ETML-ES-SLO/PRJ_2227_BoiteABruitage/soft/Version_B_MSI/README.md

"# PROJET-POBJ" 
to generate new wav file : https://tomeko.net/online_tools/wave_gen.php?lang=en
