ETML-ES-SLO/PRJ_2227_BoiteABruitage/hard/2227_BoiteBruitages_1A_LDD/Project Outputs for 2227_BoiteBruitage/Reports/Electrical Rules Check.html

Altium

# Electrical Rule Check Report

Date: | | 22.03.2023
Time: | | 09:31:39
Filename: | | C:\Users\pd55xhr\OneDrive - Education Vaud\Semestre 3\Projet\rendu design\Hardware\PCB_Project\Project Outputs for 2227_BoiteBruitage\Reports\Electrical Rules Check.html

Class | Document | Message
Warning | Schéma_Global.SchDoc | Net NetC6_2 has no driving source (Pin C6-2, Pin R26-1, Pin R28-2, Pin U5-6)
Warning | Schéma_Global.SchDoc | Net NetC9_2 has no driving source (Pin C9-2, Pin R27-1, Pin R29-2, Pin U5-3)
Warning | Schéma_Global.SchDoc | Net Pot has no driving source (Pin R25-2, Pin TP11-1, Pin U4-19)
Warning | Schéma_Global.SchDoc | Net SPI2 CLK has no driving source (Pin TP14-1, Pin U4-15, Pin U6-6)

Back to top
