ETML-ES-SLO/PRJ_2227_BoiteABruitage/hard/2227_BoiteBruitages_1A_LDD/Project Outputs for 2227_BoiteBruitage/Reports/Footprint Comparison Report.html

Altium customize

# Footprint Comparison Report

Date: | | 22.03.2023
Time: | | 09:31:40
Elapsed Time: | | 00:00:00
Filename: | | C:\Users\pd55xhr\OneDrive - Education Vaud\Semestre 3\Projet\rendu design\Hardware\PCB_Project\22270A_BoiteBruitage_LDD.PcbDoc

## Contents

Contents

Components Status Summary

Matched Components List

## Components Status Summary

## Matched Components List

Designator | Footprint | Footprint reference | Footprint to reference Library
C1 | C0805 | C0805 | C:\Users\pd55xhr\OneDrive - Education Vaud\Semestre 3\Projet\rendu design\Hardware\PCB_Project\ES_Class6C_2L.PcbLib
C2 | C0805 | C0805 | C:\Users\pd55xhr\OneDrive - Education Vaud\Semestre 3\Projet\rendu design\Hardware\PCB_Project\ES_Class6C_2L.PcbLib
C3 | C0805 | C0805 | C:\Users\pd55xhr\OneDrive - Education Vaud\Semestre 3\Projet\rendu design\Hardware\PCB_Project\ES_Class6C_2L.PcbLib
C4 | C0805 | C0805 | C:\Users\pd55xhr\OneDrive - Education Vaud\Semestre 3\Projet\rendu design\Hardware\PCB_Project\ES_Class6C_2L.PcbLib
C5 | C0805 | C0805 | C:\Users\pd55xhr\OneDrive - Education Vaud\Semestre 3\Projet\rendu design\Hardware\PCB_Project\ES_Class6C_2L.PcbLib
C6 | C0805 | C0805 | C:\Users\pd55xhr\OneDrive - Education Vaud\Semestre 3\Projet\rendu design\Hardware\PCB_Project\ES_Class6C_2L.PcbLib
C7 | C0805 | C0805 | C:\Users\pd55xhr\OneDrive - Education Vaud\Semestre 3\Projet\rendu design\Hardware\PCB_Project\ES_Class6C_2L.PcbLib
C8 | C0805 | C0805 | C:\Users\pd55xhr\OneDrive - Education Vaud\Semestre 3\Projet\rendu design\Hardware\PCB_Project\ES_Class6C_2L.PcbLib
C9 | C0805 | C0805 | C:\Users\pd55xhr\OneDrive - Education Vaud\Semestre 3\Projet\rendu design\Hardware\PCB_Project\ES_Class6C_2L.PcbLib
C10 | C0805 | C0805 | C:\Users\pd55xhr\OneDrive - Education Vaud\Semestre 3\Projet\rendu design\Hardware\PCB_Project\ES_Class6C_2L.PcbLib
C11 | C0805 | C0805 | C:\Users\pd55xhr\OneDrive - Education Vaud\Semestre 3\Projet\rendu design\Hardware\PCB_Project\ES_Class6C_2L.PcbLib
C12 | C0805 | C0805 | C:\Users\pd55xhr\OneDrive - Education Vaud\Semestre 3\Projet\rendu design\Hardware\PCB_Project\ES_Class6C_2L.PcbLib
C13 | C0805 | C0805 | C:\Users\pd55xhr\OneDrive - Education Vaud\Semestre 3\Projet\rendu design\Hardware\PCB_Project\ES_Class6C_2L.PcbLib
C14 | C0805 | C0805 | C:\Users\pd55xhr\OneDrive - Education Vaud\Semestre 3\Projet\rendu design\Hardware\PCB_Project\ES_Class6C_2L.PcbLib
C15 | C0805 | C0805 | C:\Users\pd55xhr\OneDrive - Education Vaud\Semestre 3\Projet\rendu design\Hardware\PCB_Project\ES_Class6C_2L.PcbLib
C16 | C0805 | C0805 | C:\Users\pd55xhr\OneDrive - Education Vaud\Semestre 3\Projet\rendu design\Hardware\PCB_Project\ES_Class6C_2L.PcbLib
C17 | CAP_EEEFK1E331GP | CAP_EEEFK1E331GP | C:\Users\pd55xhr\OneDrive - Education Vaud\Semestre 3\Projet\rendu design\Hardware\PCB_Project\2227_BoiteBruitage.PcbLib
C18 | CAP_EEEFK1E331GP | CAP_EEEFK1E331GP | C:\Users\pd55xhr\OneDrive - Education Vaud\Semestre 3\Projet\rendu design\Hardware\PCB_Project\2227_BoiteBruitage.PcbLib
F1 | PIN-W2/E2.8 | PIN-W2/E2.8 | C:\Users\Public\Documents\Altium\AD21\Library\Miscellaneous Devices.IntLib
J1 | GCT_MEM2067-02-180-00-A_REVB | GCT_MEM2067-02-180-00-A_REVB | C:\Users\pd55xhr\OneDrive - Education Vaud\Semestre 3\Projet\rendu design\Hardware\PCB_Project\2227_BoiteBruitage.PcbLib
J2 | CUI_SJ1-3533NG | CUI_SJ1-3533NG | C:\Users\pd55xhr\OneDrive - Education Vaud\Semestre 3\Projet\rendu design\Hardware\PCB_Project\2227_BoiteBruitage.PcbLib
L1 | CDRH125101MC | CDRH125101MC | C:\Users\pd55xhr\OneDrive - Education Vaud\Semestre 3\Projet\rendu design\Hardware\PCB_Project\2227_BoiteBruitage.PcbLib
LS1 | PIN2 | PIN2 | C:\Users\Public\Documents\Altium\AD21\Library\Miscellaneous Devices.IntLib
P1 | 691312710002 | 691312710002 | C:\Users\pd55xhr\OneDrive - Education Vaud\Semestre 3\Projet\rendu design\Hardware\PCB_Project\2227_BoiteBruitage.PcbLib
P2 | 691312710002 | 691312710002 | C:\Users\pd55xhr\OneDrive - Education Vaud\Semestre 3\Projet\rendu design\Hardware\PCB_Project\2227_BoiteBruitage.PcbLib
P3 | 691312710002 | 691312710002 | C:\Users\pd55xhr\OneDrive - Education Vaud\Semestre 3\Projet\rendu design\Hardware\PCB_Project\2227_BoiteBruitage.PcbLib
P4 | 691312710002 | 691312710002 | C:\Users\pd55xhr\OneDrive - Education Vaud\Semestre 3\Projet\rendu design\Hardware\PCB_Project\2227_BoiteBruitage.PcbLib
P5 | 691312710002 | 691312710002 | C:\Users\pd55xhr\OneDrive - Education Vaud\Semestre 3\Projet\rendu design\Hardware\PCB_Project\2227_BoiteBruitage.PcbLib
P6 | 691312710002 | 691312710002 | C:\Users\pd55xhr\OneDrive - Education Vaud\Semestre 3\Projet\rendu design\Hardware\PCB_Project\2227_BoiteBruitage.PcbLib
P7 | 691312710002 | 691312710002 | C:\Users\pd55xhr\OneDrive - Education Vaud\Semestre 3\Projet\rendu design\Hardware\PCB_Project\2227_BoiteBruitage.PcbLib
P8 | 691312710002 | 691312710002 | C:\Users\pd55xhr\OneDrive - Education Vaud\Semestre 3\Projet\rendu design\Hardware\PCB_Project\2227_BoiteBruitage.PcbLib
P9 | HDR1X6 | HDR1X6 | C:\Users\Public\Documents\Altium\AD21\Library\Miscellaneous Connectors.IntLib
P10 | 691312710002 | 691312710002 | C:\Users\pd55xhr\OneDrive - Education Vaud\Semestre 3\Projet\rendu design\Hardware\PCB_Project\2227_BoiteBruitage.PcbLib
P11 | 691312710002 | 691312710002 | C:\Users\pd55xhr\OneDrive - Education Vaud\Semestre 3\Projet\rendu design\Hardware\PCB_Project\2227_BoiteBruitage.PcbLib
P12 | MHDR1X2 | MHDR1X2 | C:\Users\Public\Documents\Altium\AD21\Library\Miscellaneous Connectors.IntLib
P13 | 691312710002 | 691312710002 | C:\Users\pd55xhr\OneDrive - Education Vaud\Semestre 3\Projet\rendu design\Hardware\PCB_Project\2227_BoiteBruitage.PcbLib
R1 | C1206 | C1206 | C:\Users\pd55xhr\OneDrive - Education Vaud\Semestre 3\Projet\rendu design\Hardware\PCB_Project\ES_Class6C_2L.PcbLib
R2 | C1206 | C1206 | C:\Users\pd55xhr\OneDrive - Education Vaud\Semestre 3\Projet\rendu design\Hardware\PCB_Project\ES_Class6C_2L.PcbLib
R3 | C1206 | C1206 | C:\Users\pd55xhr\OneDrive - Education Vaud\Semestre 3\Projet\rendu design\Hardware\PCB_Project\ES_Class6C_2L.PcbLib
R4 | C1206 | C1206 | C:\Users\pd55xhr\OneDrive - Education Vaud\Semestre 3\Projet\rendu design\Hardware\PCB_Project\ES_Class6C_2L.PcbLib
R7 | C1206 | C1206 | C:\Users\pd55xhr\OneDrive - Education Vaud\Semestre 3\Projet\rendu design\Hardware\PCB_Project\ES_Class6C_2L.PcbLib
R8 | C1206 | C1206 | C:\Users\pd55xhr\OneDrive - Education Vaud\Semestre 3\Projet\rendu design\Hardware\PCB_Project\ES_Class6C_2L.PcbLib
R9 | C1206 | C1206 | C:\Users\pd55xhr\OneDrive - Education Vaud\Semestre 3\Projet\rendu design\Hardware\PCB_Project\ES_Class6C_2L.PcbLib
R10 | C1206 | C1206 | C:\Users\pd55xhr\OneDrive - Education Vaud\Semestre 3\Projet\rendu design\Hardware\PCB_Project\ES_Class6C_2L.PcbLib
R11 | C1206 | C1206 | C:\Users\pd55xhr\OneDrive - Education Vaud\Semestre 3\Projet\rendu design\Hardware\PCB_Project\ES_Class6C_2L.PcbLib
R12 | C1206 | C1206 | C:\Users\pd55xhr\OneDrive - Education Vaud\Semestre 3\Projet\rendu design\Hardware\PCB_Project\ES_Class6C_2L.PcbLib
R13 | C1206 | C1206 | C:\Users\pd55xhr\OneDrive - Education Vaud\Semestre 3\Projet\rendu design\Hardware\PCB_Project\ES_Class6C_2L.PcbLib
R14 | C1206 | C1206 | C:\Users\pd55xhr\OneDrive - Education Vaud\Semestre 3\Projet\rendu design\Hardware\PCB_Project\ES_Class6C_2L.PcbLib
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
U9 | AP63203WU | AP63203WU | C:\Users\pd55xhr\OneDrive - Education Vaud\Semestre 3\Projet\rendu design\Hardware\PCB_Project\2227_BoiteBruitage.PcbLib
U10 | AOP_HASOP-J8 | AOP_HASOP-J8 | C:\Users\pd55xhr\OneDrive - Education Vaud\Semestre 3\Projet\rendu design\Hardware\PCB_Project\2227_BoiteBruitage.PcbLib
VREF1 | KSTN-5014_V | KSTN-5014_V | Altium Content Vault

Back to top
