ETML-ES-SLO/PRJ_2227_BoiteABruitage/soft/Version_B_MSI/JDT_2227_BoiteABruitage_POBJ_MSI.pdf

ETML | Journal de travail | PROJET- POBJ
MSI | Page 1

## Journal de Travail - Projet

### Semaine du 10.02.2025

Tâche | Temps effectué | Explication | Remarques
1er jour | 3 | Explications et répartitions des projets | J’ai choisi mon projet et ai copié le repertoire de LDD

### Semaine du 24.02.2025

Tâche | Temps effectué | Explication | Remarques
Début | 1 | Rendu du cahier des charges | Après avoir vu en diagonals le projet et le rapport qui va avec, j’ai etablie un cahier des charge et l’ai rendu
Début | 2 | Prise en main du projet | Copie des répértoires, lecture de schema et de rapport, etc

### Semaine du 10.03.2025

Tâche | Temps effectué | Explication | Remarques
Début | 3 | Prise en main du projet | Problème HW sur la version de JJE. Recherche de panne et comprehension du schéma

### Semaine du 24.03.2025

Tâche | Temps effectué | Explication | Remarques
SW | 3 | Compréhension de l’ancien code | J’essaie de comprendre l’ancien code mais pas sur de comprendre vraiment la mission qui m’a été attribué…

ETML | Journal de travail | PROJET- POBJ
MSI | Page 2

### Semaine du 07.04.2025

Tâche | Temps effectué | Explication | Remarques
Absent | - | - | -

### Semaine du 12.05.2025

SW | 1.5 | Lecture rapport pour comrpendre SW | Plus j’avance dans mon projets, moins je comprend: Le but, l’état d’avancement, le résultat attendu, etc.
SW | 1.5

### Semaine du 19.05.2025

Tâche | Temps effectué | Explication | Remarques
SW | 3 | Avancement projet | Discussion avec M.Moreno qui va m’envoyé des fichiers liés à la lecture de de fichier .wav sur carte SD avec une nouvelle machine d’états

### Semaine du 26.05.2025

Tâche | Temps effectué | Explication | Remarques
SW | 2.5 | Avancement projet | Mise au propre du code avec les fichiers fournis par M.Moreno + étude de la nouvelle machine d’état
HW | 0.5 | Problème HW | Je n’arrive pas à flasher la carte, surement problème liés a l’HW selon M.Bovey

ETML | Journal de travail | PROJET- POBJ
MSI | Page 3

### Semaine du 02.06.2025

Tâche | Temps effectué | Explication | Remarques
DOC | 1.5 | Finition de la documentation pour rendu
HW | 1 | Dépannage carte avec JMO | Je cherche une solution pour flasher la carte. Finalement Uc mort Changement du Uc
SW | 0.5 | Test de programmation | Programmation OK mais maintenant debbug

### Semaine du 09.06.2025

Tâche | Temps effectué | Explication | Remarques
férié | - | - | -

### Semaine du 16.06.2025

Tâche Temps
effectué
Explication | Remarques
