ETML-ES-SLO/PRJ_2227_BoiteABruitage/hard/2227_BoiteBruitages_1A_LDD/2227_BoiteBruitages-BOM-v1.xlsx

Name | Description | Designator | Quantity | Manufacturer 1 | Manufacturer Part Number 1 | Manufacturer Lifecycle 1 | Supplier 1 | Supplier Part Number 1 | Supplier Unit Price 1 | Supplier Subtotal 1
Cap | Capacitor | C1, C2, C3, C4, C5, C10, C16 | 7
Cap | Capacitor | C6 | 1
Cap | Capacitor | C7, C12, C13 | 3
Cap | Capacitor | C8 | 1
Cap | Capacitor | C9 | 1
Cap | Capacitor | C11, C14 | 2
Cap | Capacitor | C15 | 1
Cap Pol1 | Polarized Capacitor (Radial) | C17 | 1 | KYOCERA AVX | AEA0810220M100R | Unknown | Digi-Key | 478-AEA0810220M100RCT-ND | 0.84 | 0.84
Cap Pol1 | Polarized Capacitor (Radial) | C18 | 1 | KYOCERA AVX | AEA0810220M100R | Unknown | Digi-Key | 478-AEA0810220M100RCT-ND | 0.84 | 0.84
500 mA | Fuse | F1 | 1 | TDK EPCOS | B59975C0160A070 | Volume Production
2073-MEM2067-02-180-00-ACT-ND | 2 In 1 Connector Sd+mmc | J1 | 1 | Global Connector Technology | MEM2067-02-180-00-A | Volume Production | Newark | 87X8191 | 0.187 | 0.187
SJ1-3533NG | 3.5 mm Right-Angle Stereo Jack, 3 Pin PCB Mount, Isolated Ground | J2 | 1 | CUI | SJ1-3533NG | Unknown
4,7 uH | Fixed Inductors 22uH 2.80A 0.028ohms | L1 | 1 | TDK EPCOS | B82141A1472K | Volume Production
Speaker | Loudspeaker | LS1 | 1 | CUI | GC0351M | Unknown
691312510002 | Header, 2-Pin | P1, P2, P3, P4, P5, P6, P7, P8, P10, P11, P12, P13 | 12 | Wurth Electronics | 691312510002 | Volume Production | Digi-Key | 732-2064-ND | 0.333 | 4
76384-406LF | Header, 6-Pin | P9 | 1
Res2 | Resistor | R1, R7, R9, R11, R13, R15, R17, R19, R21, R23 | 10
Res2 | Resistor | R2, R3, R4, R8, R10, R12, R14, R16, R18, R20, R22, R24 | 12
P0915N-FC15BR100K | Res Conductive Plastic POT 100K Ohm 20% 0.05W(1/20W) 1(Elec)/1(Mech)Turns 6mm (12.1 X 14.85 X 28.5mm) Pin Panel Mount/Through Hole Box/Tray | R25 | 1
Res2 | Resistor | R26 | 1
Res2 | Resistor | R27, R28, R29 | 3
5011 | Test Point, Black, Through Hole, RoHS, Bulk | TP1, TP2, TP3, TP4, TP18 | 5 | Keystone Electronics | 5011 | Volume Production | Future Electronics | 5322706 | 0.315 | 1.58
5012 | Test Point, White, Through Hole, RoHS, Bulk | TP5, TP6, TP7, TP8, TP9, TP10, TP11, TP12, TP13, TP14, TP15 | 11 | Keystone Electronics | 5012 | Volume Production | Farnell | 2301414 | 0.31058 | 3.42
5010 | Test Point, Red, Through Hole, RoHS, Bulk | TP16, TP17, TP19, TP20 | 4 | Keystone Electronics | 5010 | Volume Production | Farnell | 2301288 | 0.2754 | 1.1
IS2805-4 |  | U1, U2, U3 | 3 | Isocom | IS2805-4 | Volume Production | Digi-Key | IS2805-4CT-ND | 1.95 | 5.85
PIC32MX230F256D-I/PT | No Description Available | U4 | 1 | Microchip | PIC32MX230F256D-I/PT | Volume Production | Avnet | 46Y8023 | 4.17 | 4.17
LM6132BIM | Dual Low Power 10 MHz Rail-to-Rail I/O Operational Amplifier, 8-pin Narrow SOIC | U5 | 1 | TI National Semiconductor | LM6132BIM | Unknown
AD5620CRMZ-1 | Single, 12-Bit nanoDACÂ® with 5 ppm/Â°C On-Chip Reference in SOT-23 | U6 | 1 | Analog Devices | AD5620CRMZ-1 | Volume Production | Farnell | 4017428 | 7.79 | 7.79
CBRHDSH1-40L |  | U7 | 1 | Central Semiconductor | CBRHDSH1-40L | Volume Production
173950536 |  | U8 | 1 | Wurth Electronics | 173950536 | Volume Production | Mouser | 710-173950536 | 6.52 | 6.52
AP63203WU |  | U9 | 1 | Diodes | AP63203WU-7 | Volume Production | Digi-Key | AP63203WU-7DICT-ND | 0.86 | 0.86
BD78310EFJ-ME2 | 1.2W MONAURAL SPEAKER AMPLIFIER | U10 | 1 | Rohm | BD78310EFJ-ME2 | Volume Production | Farnell | 3462678 | 2.11 | 2.11
5014 | Test Point, Yellow, Through Hole, RoHS, Bulk | VREF1 | 1 | Keystone Electronics | 5014 | Volume Production | Farnell | 2301290 | 0.27055 | 0.27055
