ETML-ES-SLO/PRJ_2227_BoiteABruitage/hard/2227_BoiteBruitages_1A_LDD/Project Outputs for 2227_BoiteBruitage/Export/ES_Class6C_2L.step

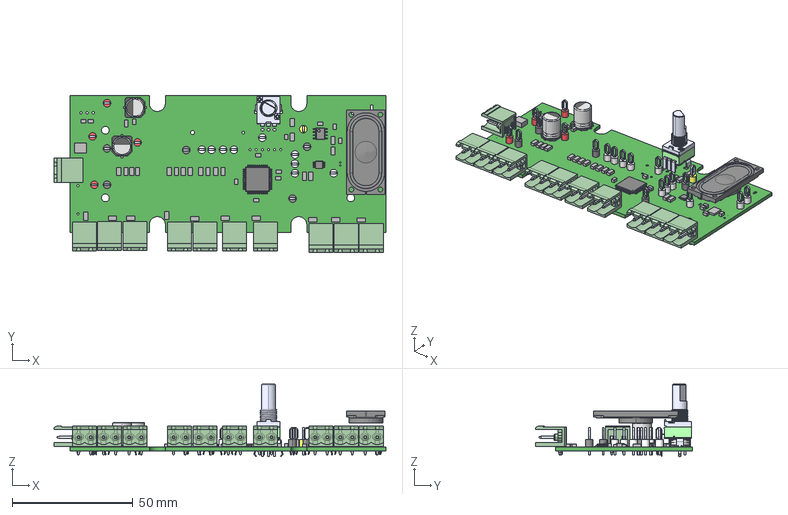
[picture p44: CAD file, 2025-01-31]
hard/2227_BoiteBruitages_1A_LDD/Project Outputs for 2227_BoiteBruitage/Export/ES_Class6C_2L.step
137.4 x 64.8 x 30.0 mm
Extruded x 47
keystone-PN5010 x 4
keystone-PN5014
BODY_M08A_35
LEAD_M08A_57 x 8
MANIFOLD_SOLID_BREP_2784
MANIFOLD_SOLID_BREP_2935
MANIFOLD_SOLID_BREP_3086
MANIFOLD_SOLID_BREP_3237
keystone-PN5012 x 11
keystone-PN5011 x 5
CUI_DEVICES_GC0351M
