ETML-ES-SLO/PRJ_2227_BoiteABruitage/hard/2227_BoiteBruitages_1A_LDD/Project Outputs for 2227_BoiteBruitage/DesignDocs/Schematic Prints.PDF

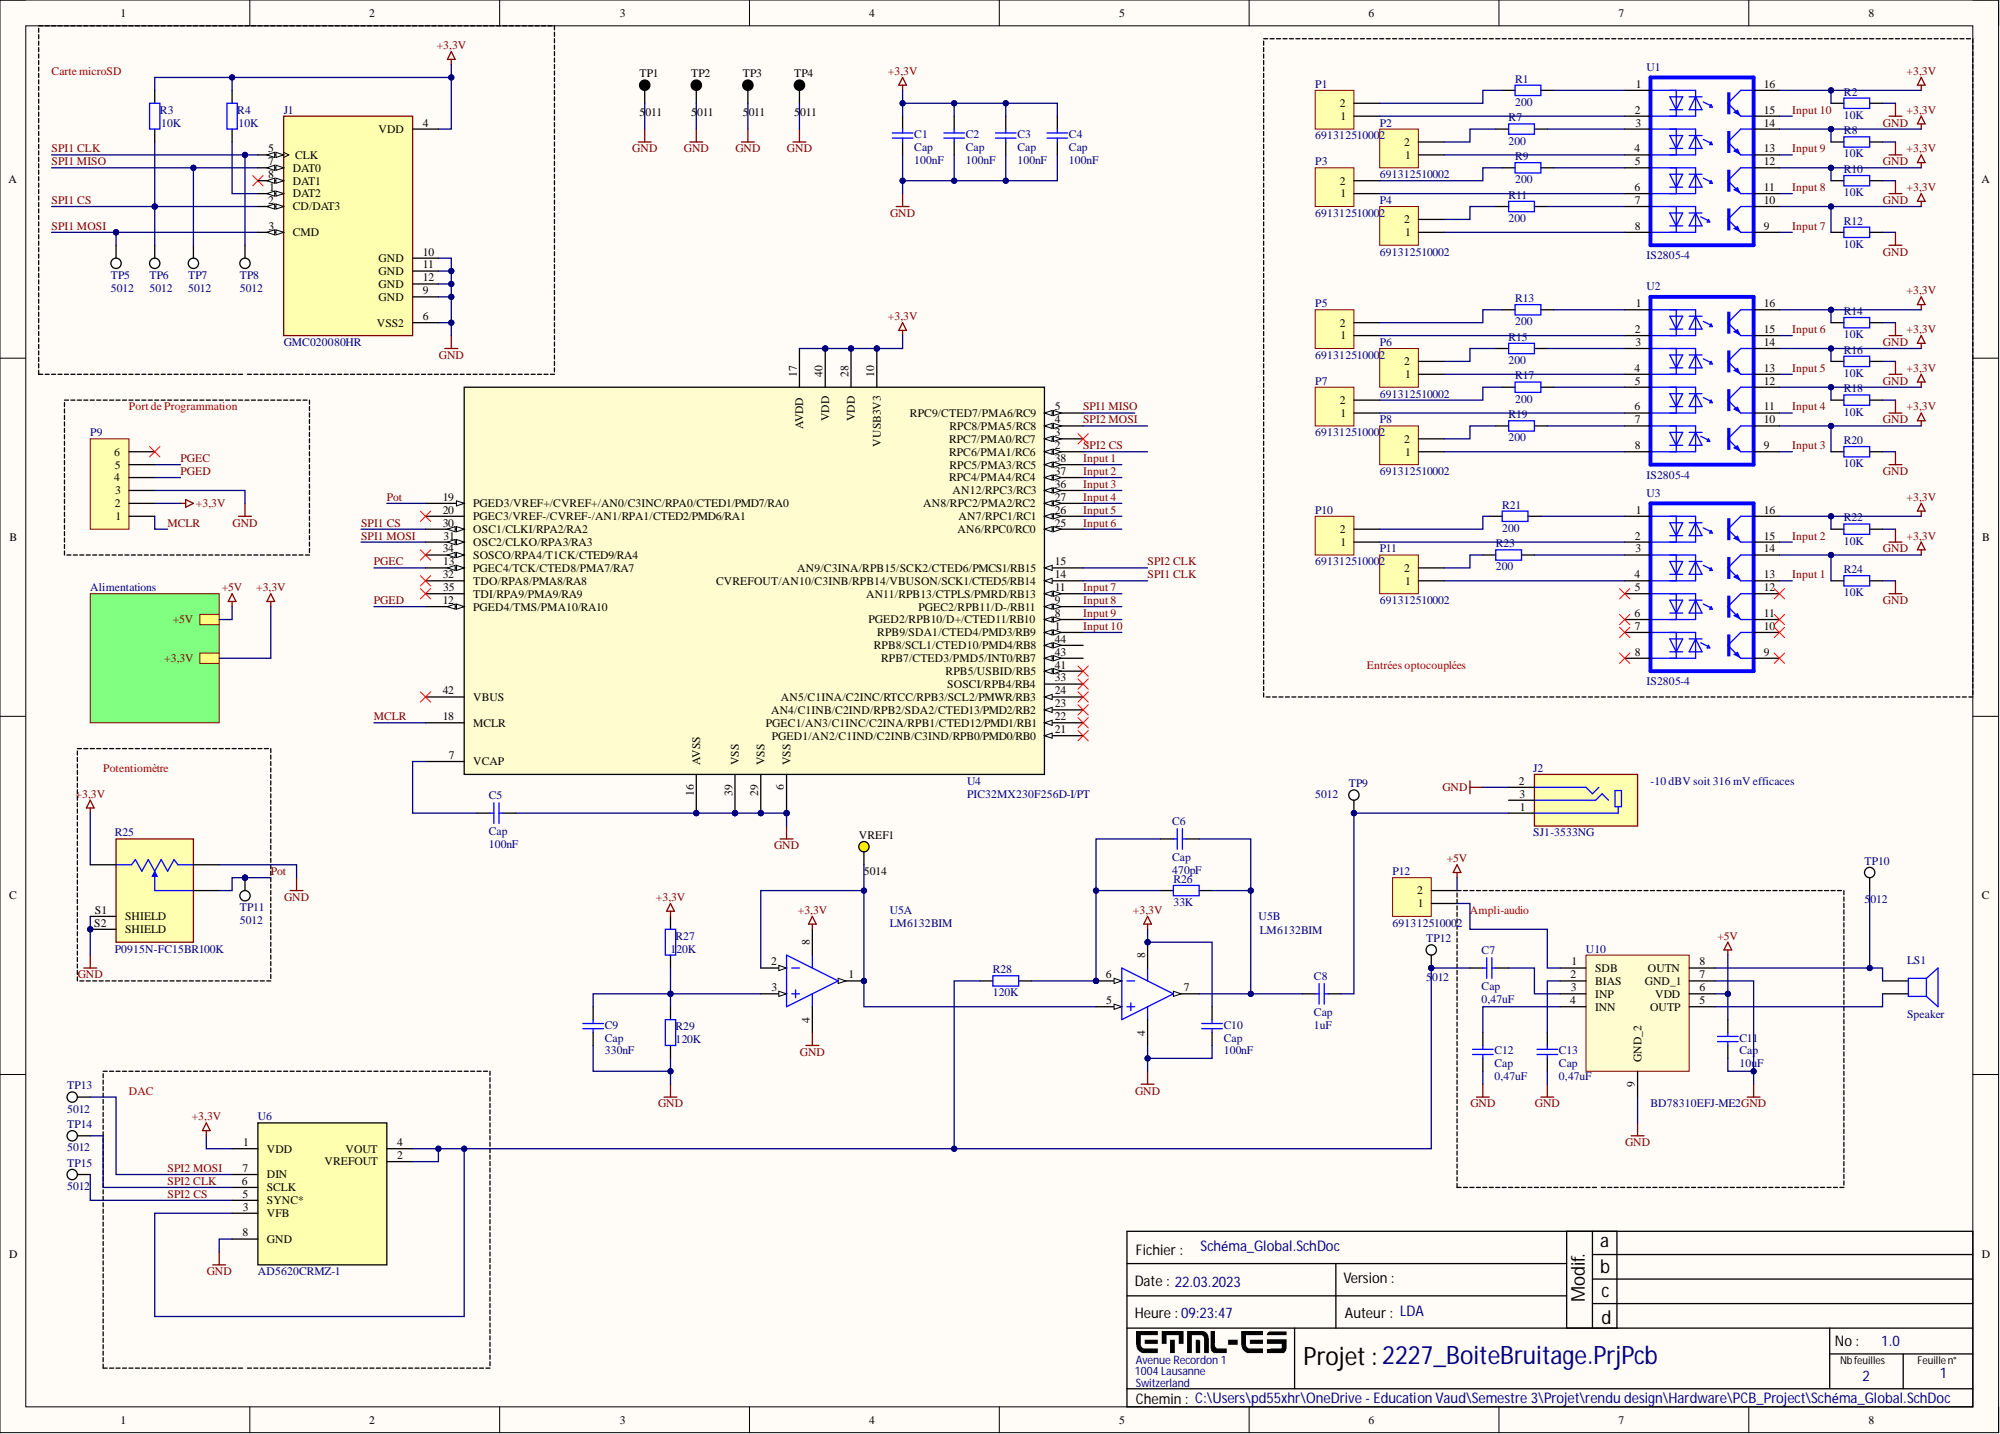
[picture p45: page 1]

-10 dBV soit 316 mV efficaces

Heure : 09:23:47 | LDA Auteur :
Avenue Recordon 1 1004 Lausanne Switzerland | Projet : 2227_BoiteBruitage.PrjPcb | No : 1.0

Nb feuilles 2 | Feuille n° 1

Chemin : C:\Users\pd55xhr\OneDrive - Education Vaud\Semestre 3\Projet\rendu design\Hardware\PCB_Project\Schéma_Global.SchDoc

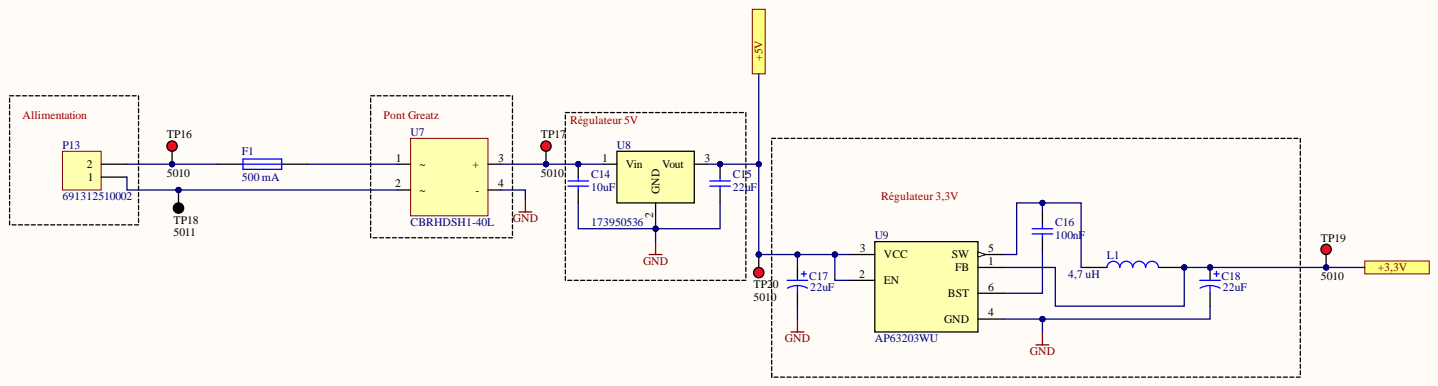
[picture p46: page 2]

Allimentat ions. S chDoc Fichier :

Date : 22.03.2023 | Version :

Heure : 09:23:48 | * Auteur :
Avenue R e cordon 1 1 00 4 Lausanne Switz e rland | Projet : 2227_BoiteBruitage.Prj P c b | No :

Nb feuille s 2 | F euille n ° 2

Chemin : C:\Users\pd55xhr\OneDrive - Educat

rojet\rendu design\Hardware\PCB_P
