ETML-ES-SLO/PRJ_2227_BoiteABruitage/hard/2227_BoiteBruitages_1A_LDD/Project Outputs for 2227_BoiteBruitage/DesignDocs/Dimensional Drawings.PDF

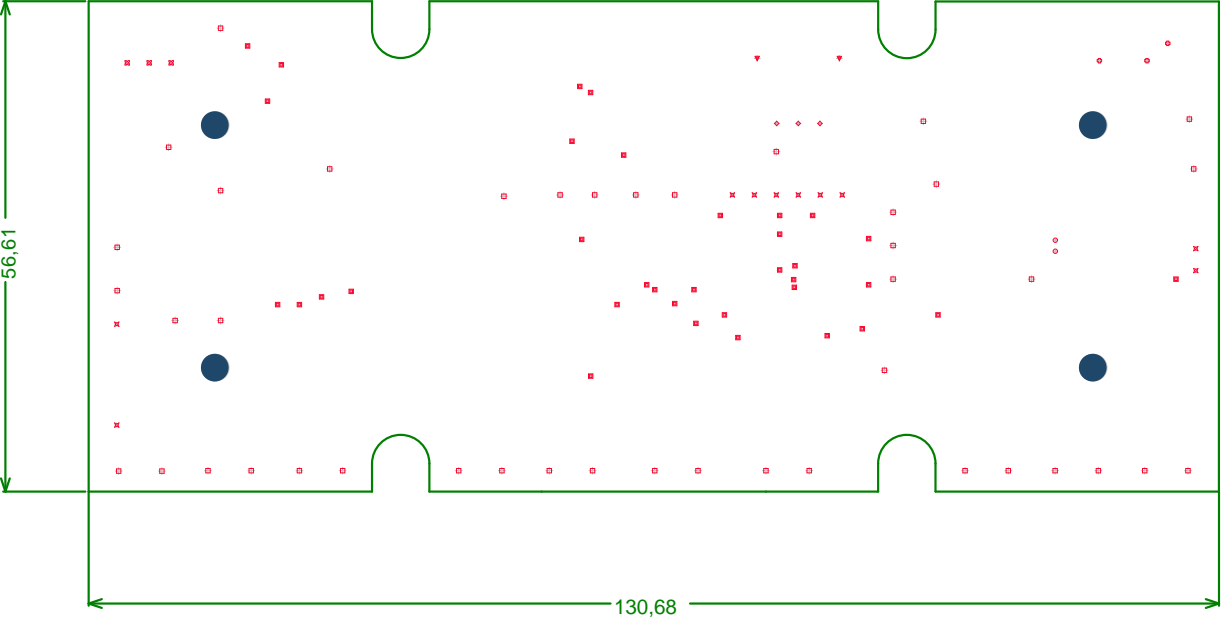
[picture p48: page 1]
