ETML-ES-SLO/PRJ_2227_BoiteABruitage/hard/2227_BoiteBruitages_1A_LDD/Project Outputs for 2227_BoiteBruitage/DesignDocs/PCB Top-Bottom Assy Dwgs.PDF

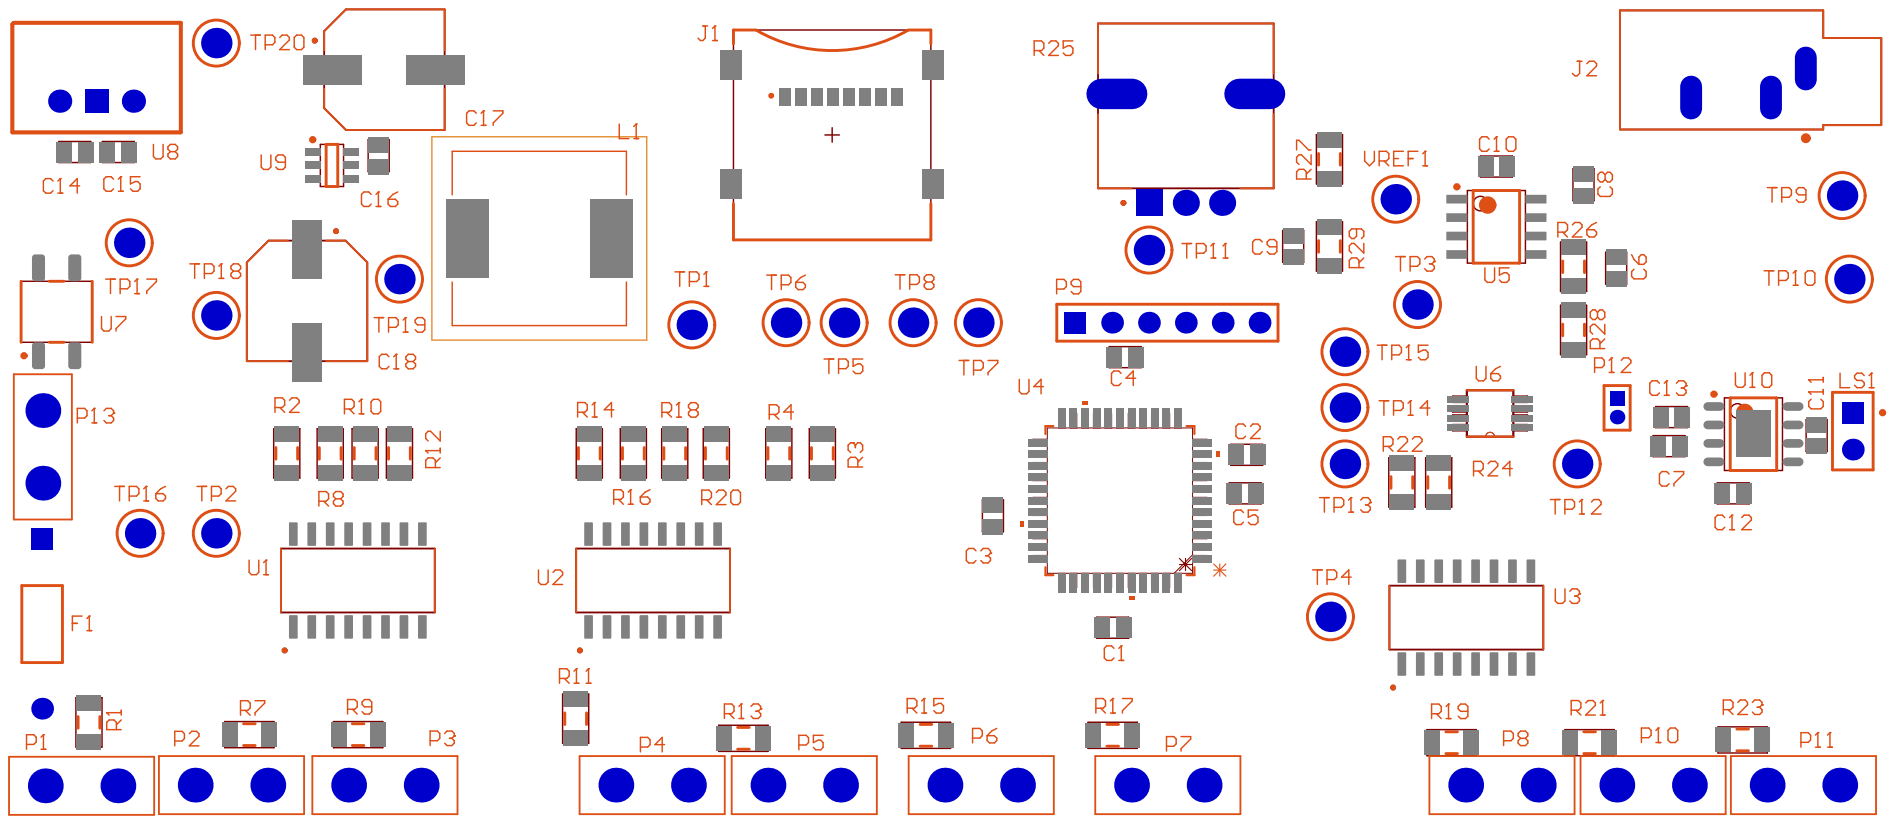
[picture p49: page 1]

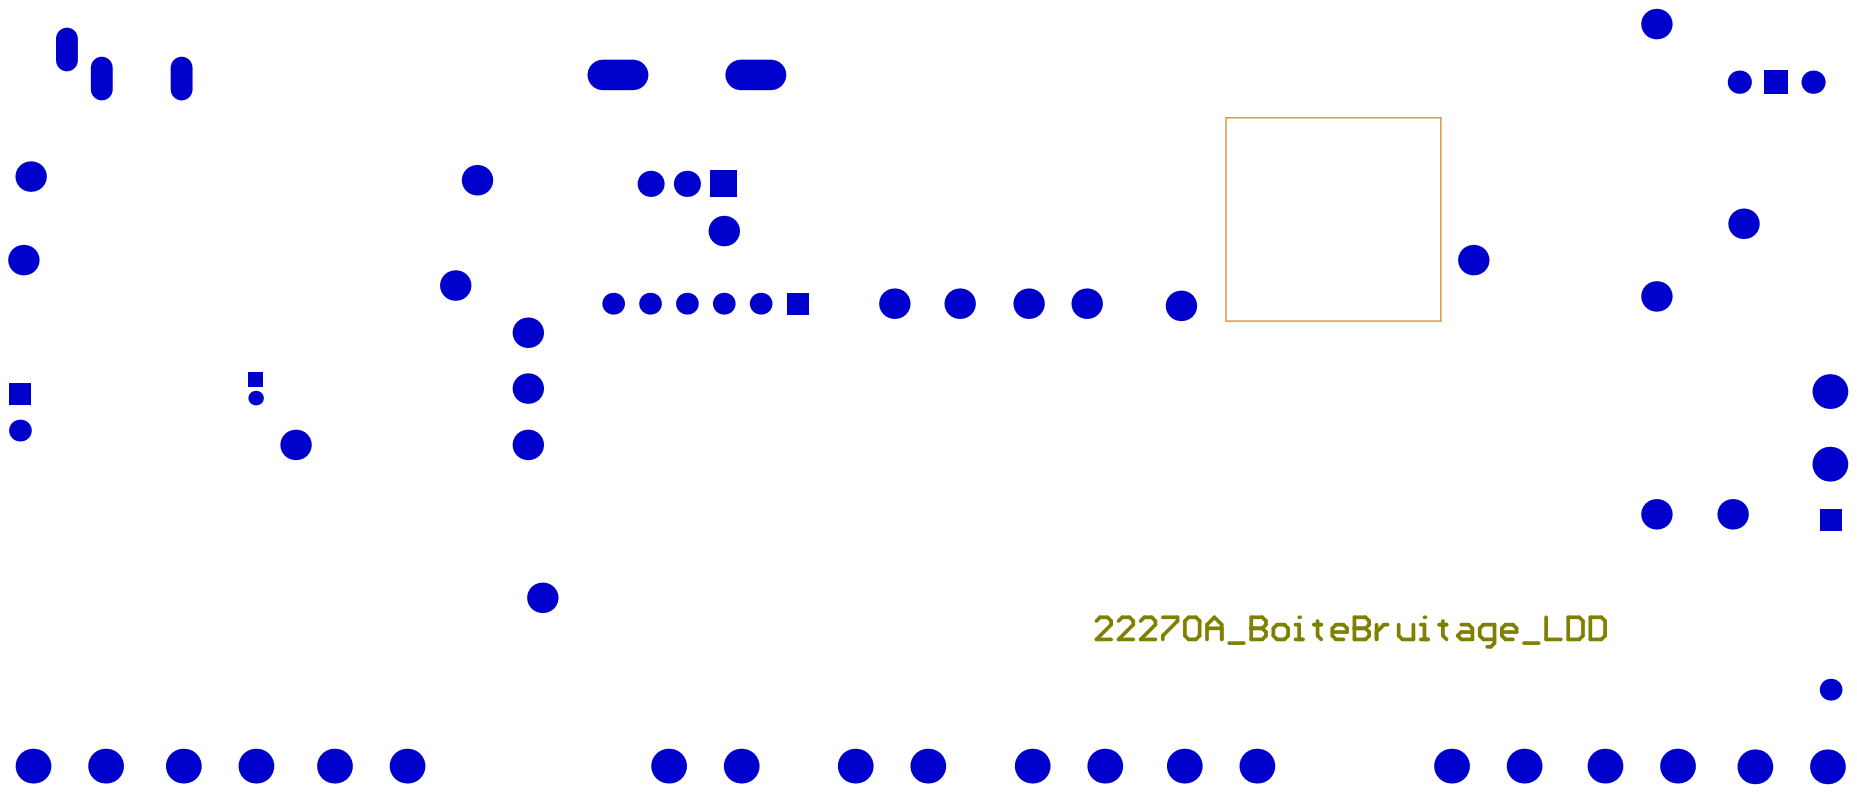
[picture p50: page 2]
