ETML-ES-SLO/PRJ_2227_BoiteABruitage/(list of files, drawings)

Other design files:
hard/2227_BoiteBruitages_1A_LDD/2227_BoiteBruitage.PrjPcb
hard/2227_BoiteBruitages_1A_LDD/22270A_BoiteBruitage_LDD.PcbDoc
hard/2227_BoiteBruitages_1A_LDD/.PcbLib
hard/2227_BoiteBruitages_1A_LDD/.SchLib
hard/2227_BoiteBruitages_1A_LDD/Allimentations.SchDoc
hard/2227_BoiteBruitages_1A_LDD/Schéma_Global.SchDoc
hard/2227_BoiteBruitages_1B_LDD/2227_BoiteBruitage.PcbLib
hard/2227_BoiteBruitages_1B_LDD/2227_BoiteBruitage.SchLib
hard/2227_BoiteBruitages_1B_LDD/2227_BoiteBruitage_1.SCHLIB
hard/2227_BoiteBruitages_1B_LDD/2227_BoiteBruitage_1B_LDD.PrjPcb
hard/2227_BoiteBruitages_1B_LDD/22270A_BoiteBruitage_LDD.PcbDoc
hard/2227_BoiteBruitages_1B_LDD/Allimentations.SchDoc
hard/2227_BoiteBruitages_1B_LDD/ES_Class6C_2L.PcbDoc
hard/2227_BoiteBruitages_1B_LDD/ES_Class6C_2L.PcbLib
hard/2227_BoiteBruitages_1B_LDD/Schéma_Global.SchDoc
