ETML-ES-SLO/PRJ_2227_BoiteABruitage/soft/Version_B_MSI/firmware/src/system_config/default/system_config.h

/*******************************************************************************
  MPLAB Harmony System Configuration Header

  File Name:
    system_config.h

  Summary:
    Build-time configuration header for the system defined by this MPLAB Harmony
    project.

  Description:
    An MPLAB Project may have multiple configurations.  This file defines the
    build-time options for a single configuration.

  Remarks:
    This configuration header must not define any prototypes or data
    definitions (or include any files that do).  It only provides macro
    definitions for build-time configuration options that are not instantiated
    until used by another MPLAB Harmony module or application.

    Created with MPLAB Harmony Version 2.06
*******************************************************************************/

// DOM-IGNORE-BEGIN
/*******************************************************************************
Copyright (c) 2013-2015 released Microchip Technology Inc.  All rights reserved.

Microchip licenses to you the right to use, modify, copy and distribute
Software only when embedded on a Microchip microcontroller or digital signal
controller that is integrated into your product or third party product
(pursuant to the sublicense terms in the accompanying license agreement).

You should refer to the license agreement accompanying this Software for
additional information regarding your rights and obligations.

SOFTWARE AND DOCUMENTATION ARE PROVIDED AS IS WITHOUT WARRANTY OF ANY KIND,
EITHER EXPRESS OR IMPLIED, INCLUDING WITHOUT LIMITATION, ANY WARRANTY OF
MERCHANTABILITY, TITLE, NON-INFRINGEMENT AND FITNESS FOR A PARTICULAR PURPOSE.
IN NO EVENT SHALL MICROCHIP OR ITS LICENSORS BE LIABLE OR OBLIGATED UNDER
CONTRACT, NEGLIGENCE, STRICT LIABILITY, CONTRIBUTION, BREACH OF WARRANTY, OR
OTHER LEGAL EQUITABLE THEORY ANY DIRECT OR INDIRECT DAMAGES OR EXPENSES
INCLUDING BUT NOT LIMITED TO ANY INCIDENTAL, SPECIAL, INDIRECT, PUNITIVE OR
CONSEQUENTIAL DAMAGES, LOST PROFITS OR LOST DATA, COST OF PROCUREMENT OF
SUBSTITUTE GOODS, TECHNOLOGY, SERVICES, OR ANY CLAIMS BY THIRD PARTIES
(INCLUDING BUT NOT LIMITED TO ANY DEFENSE THEREOF), OR OTHER SIMILAR COSTS.
*******************************************************************************/
// DOM-IGNORE-END

#ifndef _SYSTEM_CONFIG_H
#define _SYSTEM_CONFIG_H

// *****************************************************************************
// *****************************************************************************
// Section: Included Files
// *****************************************************************************
// *****************************************************************************
/*  This section Includes other configuration headers necessary to completely
    define this configuration.
*/


// DOM-IGNORE-BEGIN
#ifdef __cplusplus  // Provide C++ Compatibility

extern "C" {

#endif
// DOM-IGNORE-END

// *****************************************************************************
// *****************************************************************************
// Section: System Service Configuration
// *****************************************************************************
// *****************************************************************************
// *****************************************************************************
/* Common System Service Configuration Options
*/
#define SYS_VERSION_STR           "2.06"
#define SYS_VERSION               20600

// *****************************************************************************
/* Clock System Service Configuration Options
*/
#define SYS_CLK_FREQ                        40000000ul
#define SYS_CLK_BUS_PERIPHERAL_1            40000000ul
#define SYS_CLK_UPLL_BEFORE_DIV2_FREQ       96000000ul
#define SYS_CLK_CONFIG_PRIMARY_XTAL         8000000ul
#define SYS_CLK_CONFIG_SECONDARY_XTAL       32768ul
   
/*** Ports System Service Configuration ***/
#define SYS_PORT_A_ANSEL        0xF875
#define SYS_PORT_A_TRIS         0xFFE5
#define SYS_PORT_A_LAT          0x0000
#define SYS_PORT_A_ODC          0x0000
#define SYS_PORT_A_CNPU         0x0000
#define SYS_PORT_A_CNPD         0x0000
#define SYS_PORT_A_CNEN         0x0000

#define SYS_PORT_B_ANSEL        0x104D
#define SYS_PORT_B_TRIS         0x12CF
#define SYS_PORT_B_LAT          0x0100
#define SYS_PORT_B_ODC          0x0000
#define SYS_PORT_B_CNPU         0x0000
#define SYS_PORT_B_CNPD         0x2E00
#define SYS_PORT_B_CNEN         0x0000

#define SYS_PORT_C_ANSEL        0xFC00
#define SYS_PORT_C_TRIS         0xFDFF
#define SYS_PORT_C_LAT          0x0000
#define SYS_PORT_C_ODC          0x0000
#define SYS_PORT_C_CNPU         0x0000
#define SYS_PORT_C_CNPD         0x003F
#define SYS_PORT_C_CNEN         0x0000


/*** File System Service Configuration ***/

#define SYS_FS_MEDIA_NUMBER         	1

#define SYS_FS_VOLUME_NUMBER		1

#define SYS_FS_AUTOMOUNT_ENABLE		false
#define SYS_FS_MAX_FILES	    	1
#define SYS_FS_MAX_FILE_SYSTEM_TYPE 	1
#define SYS_FS_MEDIA_MAX_BLOCK_SIZE  	512
#define SYS_FS_MEDIA_MANAGER_BUFFER_SIZE 512
#define SYS_FS_FILE_NAME_LEN 255
#define SYS_FS_CWD_STRING_LEN 1024


#define SYS_FS_MEDIA_TYPE_IDX0 				
#define SYS_FS_TYPE_IDX0 					










/*** Interrupt System Service Configuration ***/
#define SYS_INT                     true
/*** Timer System Service Configuration ***/
#define SYS_TMR_POWER_STATE             SYS_MODULE_POWER_RUN_FULL
#define SYS_TMR_DRIVER_INDEX            DRV_TMR_INDEX_0
#define SYS_TMR_MAX_CLIENT_OBJECTS      5
#define SYS_TMR_FREQUENCY               1000
#define SYS_TMR_FREQUENCY_TOLERANCE     10
#define SYS_TMR_UNIT_RESOLUTION         10000
#define SYS_TMR_CLIENT_TOLERANCE        10
#define SYS_TMR_INTERRUPT_NOTIFICATION  true

// *****************************************************************************
// *****************************************************************************
// Section: Driver Configuration
// *****************************************************************************
// *****************************************************************************

/*** SDCARD Driver Configuration ***/
#define DRV_SDCARD_INSTANCES_NUMBER     1
#define DRV_SDCARD_CLIENTS_NUMBER       1
#define DRV_SDCARD_INDEX_MAX            1
#define DRV_SDCARD_INDEX                DRV_SDCARD_INDEX_0
#define DRV_SDCARD_QUEUE_POOL_SIZE      10
#define DRV_SDCARD_SPI_DRV_INSTANCE     0

#define DRV_SDCARD_SYS_FS_REGISTER




/*** SPI Driver Configuration ***/
#define DRV_SPI_NUMBER_OF_MODULES		2
/*** Driver Compilation and static configuration options. ***/
/*** Select SPI compilation units.***/
#define DRV_SPI_POLLED 				0
#define DRV_SPI_ISR 				1
#define DRV_SPI_MASTER 				1
#define DRV_SPI_SLAVE 				0
#define DRV_SPI_RM 					0
#define DRV_SPI_EBM 				1
#define DRV_SPI_8BIT 				1
#define DRV_SPI_16BIT 				0
#define DRV_SPI_32BIT 				0
#define DRV_SPI_DMA 				0

/*** SPI Driver Static Allocation Options ***/
#define DRV_SPI_INSTANCES_NUMBER 		1
#define DRV_SPI_CLIENTS_NUMBER 			1
#define DRV_SPI_ELEMENTS_PER_QUEUE 		10
/* SPI Driver Instance 0 Configuration */
#define DRV_SPI_SPI_ID_IDX0 				SPI_ID_1
#define DRV_SPI_TASK_MODE_IDX0 				DRV_SPI_TASK_MODE_ISR
#define DRV_SPI_SPI_MODE_IDX0				DRV_SPI_MODE_MASTER
#define DRV_SPI_ALLOW_IDLE_RUN_IDX0			false
#define DRV_SPI_SPI_PROTOCOL_TYPE_IDX0 		DRV_SPI_PROTOCOL_TYPE_STANDARD
#define DRV_SPI_COMM_WIDTH_IDX0 			SPI_COMMUNICATION_WIDTH_8BITS
#define DRV_SPI_CLOCK_SOURCE_IDX0 		    SPI_BAUD_RATE_PBCLK_CLOCK
#define DRV_SPI_SPI_CLOCK_IDX0 				CLK_BUS_PERIPHERAL_1
#define DRV_SPI_BAUD_RATE_IDX0 				500000
#define DRV_SPI_BUFFER_TYPE_IDX0 			DRV_SPI_BUFFER_TYPE_ENHANCED
#define DRV_SPI_CLOCK_MODE_IDX0 			DRV_SPI_CLOCK_MODE_IDLE_LOW_EDGE_FALL
#define DRV_SPI_INPUT_PHASE_IDX0 			SPI_INPUT_SAMPLING_PHASE_AT_END
#define DRV_SPI_TRANSMIT_DUMMY_BYTE_VALUE_IDX0      0xFF

#define DRV_SPI_TX_INT_SOURCE_IDX0 			INT_SOURCE_SPI_1_TRANSMIT
#define DRV_SPI_RX_INT_SOURCE_IDX0 			INT_SOURCE_SPI_1_RECEIVE
#define DRV_SPI_ERROR_INT_SOURCE_IDX0 		INT_SOURCE_SPI_1_ERROR
#define DRV_SPI_INT_VECTOR_IDX0				INT_VECTOR_SPI1
#define DRV_SPI_INT_PRIORITY_IDX0			INT_PRIORITY_LEVEL1
#define DRV_SPI_INT_SUB_PRIORITY_IDX0		INT_SUBPRIORITY_LEVEL0        
#define DRV_SPI_QUEUE_SIZE_IDX0 			10
#define DRV_SPI_RESERVED_JOB_IDX0 			0
/*** Timer Driver Configuration ***/
#define DRV_TMR_INTERRUPT_MODE             true

/*** Timer Driver 0 Configuration ***/
#define DRV_TMR_PERIPHERAL_ID_IDX0          TMR_ID_2
#define DRV_TMR_INTERRUPT_SOURCE_IDX0       INT_SOURCE_TIMER_2
#define DRV_TMR_INTERRUPT_VECTOR_IDX0       INT_VECTOR_T2
#define DRV_TMR_ISR_VECTOR_IDX0             _TIMER_2_VECTOR
#define DRV_TMR_INTERRUPT_PRIORITY_IDX0     INT_PRIORITY_LEVEL2
#define DRV_TMR_INTERRUPT_SUB_PRIORITY_IDX0 INT_SUBPRIORITY_LEVEL0
#define DRV_TMR_CLOCK_SOURCE_IDX0           DRV_TMR_CLKSOURCE_INTERNAL
#define DRV_TMR_PRESCALE_IDX0               TMR_PRESCALE_VALUE_4
#define DRV_TMR_OPERATION_MODE_IDX0         DRV_TMR_OPERATION_MODE_16_BIT
#define DRV_TMR_ASYNC_WRITE_ENABLE_IDX0     false
#define DRV_TMR_POWER_STATE_IDX0            

#define DRV_TMR_PERIPHERAL_ID_IDX1          TMR_ID_4
#define DRV_TMR_INTERRUPT_SOURCE_IDX1       INT_SOURCE_TIMER_4
#define DRV_TMR_INTERRUPT_VECTOR_IDX1       INT_VECTOR_T4
#define DRV_TMR_ISR_VECTOR_IDX1             _TIMER_4_VECTOR
#define DRV_TMR_INTERRUPT_PRIORITY_IDX1     INT_PRIORITY_LEVEL3
#define DRV_TMR_INTERRUPT_SUB_PRIORITY_IDX1 INT_SUBPRIORITY_LEVEL0
#define DRV_TMR_CLOCK_SOURCE_IDX1           DRV_TMR_CLKSOURCE_INTERNAL
#define DRV_TMR_PRESCALE_IDX1               TMR_PRESCALE_VALUE_2
#define DRV_TMR_OPERATION_MODE_IDX1         DRV_TMR_OPERATION_MODE_16_BIT

#define DRV_TMR_ASYNC_WRITE_ENABLE_IDX1     false
#define DRV_TMR_POWER_STATE_IDX1            
/*** Timer Driver 2 Configuration ***/
#define DRV_TMR_PERIPHERAL_ID_IDX2          TMR_ID_1
#define DRV_TMR_INTERRUPT_SOURCE_IDX2       INT_SOURCE_TIMER_1
#define DRV_TMR_INTERRUPT_VECTOR_IDX2       INT_VECTOR_T1
#define DRV_TMR_ISR_VECTOR_IDX2             _TIMER_1_VECTOR
#define DRV_TMR_INTERRUPT_PRIORITY_IDX2     INT_PRIORITY_LEVEL1
#define DRV_TMR_INTERRUPT_SUB_PRIORITY_IDX2 INT_SUBPRIORITY_LEVEL0
#define DRV_TMR_CLOCK_SOURCE_IDX2           DRV_TMR_CLKSOURCE_INTERNAL
#define DRV_TMR_PRESCALE_IDX2               TMR_PRESCALE_VALUE_256
#define DRV_TMR_OPERATION_MODE_IDX2         DRV_TMR_OPERATION_MODE_16_BIT
#define DRV_TMR_ASYNC_WRITE_ENABLE_IDX2     false
#define DRV_TMR_POWER_STATE_IDX2            

 
// *****************************************************************************
// *****************************************************************************
// Section: Middleware & Other Library Configuration
// *****************************************************************************
// *****************************************************************************



// *****************************************************************************
// *****************************************************************************
// Section: Application Configuration
// *****************************************************************************
// *****************************************************************************
/*** Application Defined Pins ***/

/*** Functions for SPI1_CS pin ***/
#define SPI1_CSToggle() PLIB_PORTS_PinToggle(PORTS_ID_0, PORT_CHANNEL_B, PORTS_BIT_POS_4)
#define SPI1_CSOn() PLIB_PORTS_PinSet(PORTS_ID_0, PORT_CHANNEL_B, PORTS_BIT_POS_4)
#define SPI1_CSOff() PLIB_PORTS_PinClear(PORTS_ID_0, PORT_CHANNEL_B, PORTS_BIT_POS_4)
#define SPI1_CSStateGet() PLIB_PORTS_PinGetLatched(PORTS_ID_0, PORT_CHANNEL_B, PORTS_BIT_POS_4)
#define SPI1_CSStateSet(Value) PLIB_PORTS_PinWrite(PORTS_ID_0, PORT_CHANNEL_B, PORTS_BIT_POS_4, Value)

/*** Functions for CS_DAC pin ***/
#define CS_DACToggle() PLIB_PORTS_PinToggle(PORTS_ID_0, PORT_CHANNEL_B, PORTS_BIT_POS_8)
#define CS_DACOn() PLIB_PORTS_PinSet(PORTS_ID_0, PORT_CHANNEL_B, PORTS_BIT_POS_8)
#define CS_DACOff() PLIB_PORTS_PinClear(PORTS_ID_0, PORT_CHANNEL_B, PORTS_BIT_POS_8)
#define CS_DACStateGet() PLIB_PORTS_PinGetLatched(PORTS_ID_0, PORT_CHANNEL_B, PORTS_BIT_POS_8)
#define CS_DACStateSet(Value) PLIB_PORTS_PinWrite(PORTS_ID_0, PORT_CHANNEL_B, PORTS_BIT_POS_8, Value)

/*** Functions for Input_1 pin ***/
#define Input_1StateGet() PLIB_PORTS_PinGet(PORTS_ID_0, PORT_CHANNEL_B, PORTS_BIT_POS_9)

/*** Functions for Input_2 pin ***/
#define Input_2StateGet() PLIB_PORTS_PinGet(PORTS_ID_0, PORT_CHANNEL_B, PORTS_BIT_POS_10)

/*** Functions for Input_3 pin ***/
#define Input_3StateGet() PLIB_PORTS_PinGet(PORTS_ID_0, PORT_CHANNEL_B, PORTS_BIT_POS_11)

/*** Functions for Input_4 pin ***/
#define Input_4StateGet() PLIB_PORTS_PinGet(PORTS_ID_0, PORT_CHANNEL_B, PORTS_BIT_POS_13)

/*** Functions for Input_5 pin ***/
#define Input_5StateGet() PLIB_PORTS_PinGet(PORTS_ID_0, PORT_CHANNEL_C, PORTS_BIT_POS_0)

/*** Functions for Input_6 pin ***/
#define Input_6StateGet() PLIB_PORTS_PinGet(PORTS_ID_0, PORT_CHANNEL_C, PORTS_BIT_POS_1)

/*** Functions for Input_7 pin ***/
#define Input_7StateGet() PLIB_PORTS_PinGet(PORTS_ID_0, PORT_CHANNEL_C, PORTS_BIT_POS_2)

/*** Functions for Input_8 pin ***/
#define Input_8StateGet() PLIB_PORTS_PinGet(PORTS_ID_0, PORT_CHANNEL_C, PORTS_BIT_POS_3)

/*** Functions for Input_9 pin ***/
#define Input_9StateGet() PLIB_PORTS_PinGet(PORTS_ID_0, PORT_CHANNEL_C, PORTS_BIT_POS_4)

/*** Functions for Input_10 pin ***/
#define Input_10StateGet() PLIB_PORTS_PinGet(PORTS_ID_0, PORT_CHANNEL_C, PORTS_BIT_POS_5)


/*** Application Instance 0 Configuration ***/

//DOM-IGNORE-BEGIN
#ifdef __cplusplus
}
#endif
//DOM-IGNORE-END

#endif // _SYSTEM_CONFIG_H
/*******************************************************************************
 End of File
*/
