ETML-ES-SLO/PRJ_2227_BoiteABruitage/soft/Softgénérale_1A_LDD/firmware/src/dac_ad5620.h

#ifndef dac_ad5620_H
#define dac_ad5620_H

/*--------------------------------------------------------*/
// dac_ad5620_H.h
/*--------------------------------------------------------*/
//	Description :	Utiilisation DAC AD5620
//
//	Auteur 		: 	LDD
//	Version		:	V1.0
//	Compilateur	:	XC32 V2.50
//
/*--------------------------------------------------------*/



#include <stdint.h>

// prototypes des fonctions
void Dac_Init(void);
void Dac_Write( uint16_t ech);
void spi_write( uint8_t Val);

#endif // dac_ad5620_H
