ETML-ES-SLO/PRJ_2227_BoiteABruitage/soft/Softgénérale_1A_LDD/firmware/src/Mc32SpiUtil.c

// Mc32SpiUtil.C
// Utilitaire  SPI
//
//	Description : 	fonctions SPI CCS like
//	Auteur 		: 	C. HUBER
//      Création	: 	08.04.2014
//      Modifications   :       09.02.2015 CHR

//  LISTE DES MODIFICATIONS :
//      Utilisation des stdint                  09.02.2015 CHR
//      Adaptation à la plib_spi                09.02.2015 CHR
//      maj version compilateur et Harmony      24.05.2016 CHR
//      Correction de la séquence de lecture    25.05.2016 CHR
//      Version KIT     PCB 11020_B
//	Version		:	V1.2
//	Compilateur	:	XC32 V1.40 + Harmony 1.06
//
/*--------------------------------------------------------*/

// #define MARKER_READ 1

#include "app.h"
#include "Mc32SpiUtil.h"



//void spi_write1( uint8_t Val){
//   int SpiBusy;
//   
//   PLIB_SPI_BufferWrite(SPI_ID_2, Val);
//
//   do {
//     SpiBusy =  PLIB_SPI_IsBusy(SPI_ID_2) ;
//   } while (SpiBusy == 1);
//   
//}
