ETML-ES-SLO/PRJ_2227_BoiteABruitage/(commit log)

2025-01-31 MAJ PRJ 2227 - 30.01.2025
    [.PcbLib, .SchLib, 22270A_BoiteBruitage_LDD.PcbDoc, 2227_BoiteBruitage.PcbLib, 2227_BoiteBruitage.PrjPcb, 2227_BoiteBruitage.SchLib, 2227_BoiteBruitage_1.SCHLIB, 2227_BoiteBruitage_1B_LDD.PrjPcb]
2025-06-03 MAJ dossier -> add gitignore + ajouts MSI
    [22270A_BoiteBruitage_LDD.PcbDoc, 2227_BoiteBruitage.PcbLib, 2227_BoiteBruitage.SchLib, 2227_BoiteBruitage_1.SCHLIB, 2227_BoiteBruitage_1B_LDD.PrjPcb, 2227_BoiteBruitages-BOM-v1.xlsx, Allimentations.SchDoc, ES_Class6C_2L.PcbDoc]
